fencercensor/esp32-vps-radio/docs/FIRMWARE_SETUP_AR.md

# تجهيز ورفع برنامج ESP32

## 1. إنشاء ملف الإعداد الخاص

انسخ:

```text
firmware/radio_config.example.h
```

إلى:

```text
firmware/radio_config.h
```

ثم عدّل أربع قيم:

- `RADIO_GATEWAY_HOST`: عنوان الخادم أو عنوان الـOrigin الذي يصل إليه ESP32.
- `RADIO_GATEWAY_HTTP_HOST`: اسم الموقع الذي يرسله ESP داخل ترويسة `Host`.
- `RADIO_GATEWAY_PORT`: غالبًا `80` في هذا الإصدار.
- `RADIO_SETUP_AP_PASSWORD`: كلمة مرور فريدة من 8 أحرف على الأقل لشبكة الإعداد المؤقتة.

ملف `radio_config.h` متجاهل في Git ولا يجب نشره.

## 2. إعداد Arduino IDE

1. ثبّت Arduino IDE.
2. أضف حزمة لوحات Espressif ESP32.
3. استخدم الإصدار `2.0.17` للبناء الموثق لهذا المشروع.
4. اختر `ESP32 Dev Module`.
5. اختر Flash Size بحجم `4MB` وPartition Scheme من نوع `Huge APP` إذا احتجت مساحة أكبر.
6. افتح `firmware/vps_radio_test.ino`.
7. تأكد أن `ima_adpcm.h` و`radio_config.h` في نفس مجلد ملف `.ino`.
8. نفّذ Verify ثم Upload.

لا يحتاج البرنامج مكتبات خارجية غير الموجودة في حزمة ESP32؛ يستخدم WiFi وWebServer وPreferences وI2S من الـCore.

## 3. إعداد Wi-Fi أول مرة

إذا لم يجد الجهاز شبكات محفوظة فسيفتح شبكة:

```text
ESP-Radio-Setup
```

1. اتصل بها باستخدام كلمة المرور التي كتبتها في `RADIO_SETUP_AP_PASSWORD`.
2. افتح `http://192.168.4.1`.
3. أدخل من شبكة واحدة إلى خمس شبكات بالترتيب.
4. اضغط حفظ؛ سيعيد ESP32 تشغيل نفسه.

لفتح الإعداد لاحقًا، اضغط زر السابق `GPIO32` وزر التالي `GPIO27` معًا أربع ثوانٍ.

كلمات مرور Wi-Fi تُحفظ في NVS/Preferences داخل الجهاز، ولا تُطبع في Serial ولا تُكتب في ملفات المشروع.

## 4. علامات التشغيل في Serial Monitor

استخدم سرعة `115200` وابحث عن:

- `wired=1`: خرج DAC السلكي يعمل.
- `wifi=3`: اتصال Wi-Fi قائم.
- `primed=1`: البافر وصل إلى كمية التشغيل.
- `channels=1`: البث قادم بصيغة Mono المطلوبة.
- `buffer_blocks`: عدد بلوكات الصوت الموجودة محليًا.
- `underruns=0`: البافر لم يفرغ منذ التشغيل.
- `reconnects=0`: لا توجد إعادة اتصال منذ التشغيل.

نجاح الرفع أو ظهور هذه القيم لا يثبت جودة الصوت وحده؛ الحكم النهائي يكون بالسماع من خرج AUX.

## 5. تحديث المحطات

ESP32 يسحب أسماء ومعرفات المحطات من `/esp-radio/device-config.php`. عند تعديل قائمة المحطات على السيرفر، تحفظ النسخة الجديدة في Preferences ويستخدمها الجهاز بدون إعادة بناء البرنامج.

## لماذا لا يوجد ملف BIN جاهز؟

ملف BIN يمكن أن يحتوي عنوان خادمك وإعداداتك الخاصة، كما يصعب مراجعة محتواه على GitHub. لذلك المستودع ينشر المصدر فقط، وكل مستخدم يبني BIN الخاص به من ملف إعداد غير منشور.
