fencercensor/esp32-vps-radio/firmware/radio_config.example.h

#pragma once

// Copy to radio_config.h. This private file is ignored by Git.
// Replace the documentation address with your numeric origin IPv4 address.
#define RADIO_GATEWAY_HOST "192.0.2.1"
// This must match the HTTPS certificate and the server virtual host.
#define RADIO_GATEWAY_HTTP_HOST "radio.example.com"
#define RADIO_GATEWAY_PORT 443
// Choose a unique WPA2 password of 8 to 63 characters before using the portal.
#define RADIO_SETUP_AP_PASSWORD "CHANGE_ME_TO_A_UNIQUE_PASSWORD"

// Public ISRG Root X1 trust anchor, not a deployment certificate or private key.
// Source: https://letsencrypt.org/certs/isrgrootx1.pem
// Replace with your provider's root CA if it uses a different certificate chain.
static const char RADIO_GATEWAY_CA[] = R"CERT(-----BEGIN CERTIFICATE-----
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
-----END CERTIFICATE-----
)CERT";
