fencercensor/esp32-vps-radio/(commit log)

2026-09-17 Initial public release of ESP32 VPS radio
2026-09-17 Replace wiring image with PDF connection pages
